NavinduThimodya/High-Frequency-Amplifier-Design/Images/WhatsApp Image 2023-11-27 at 21.41.31_52dbc793.jpg

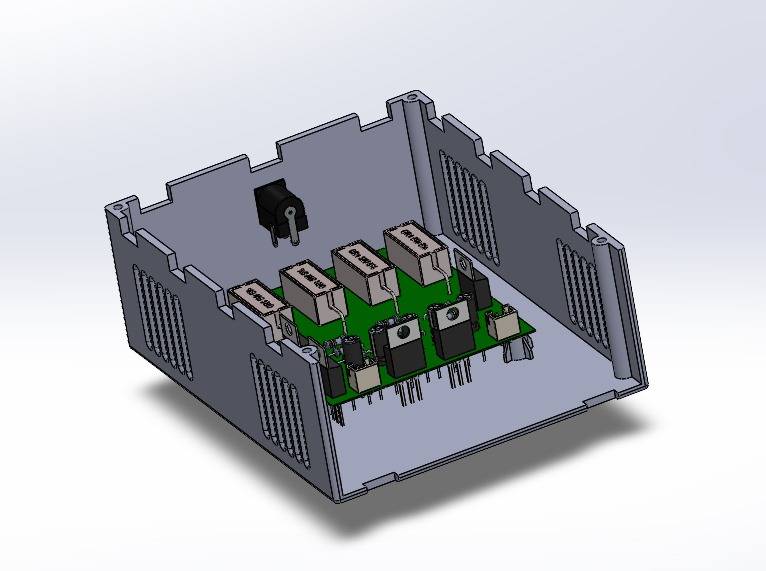
Images/WhatsApp Image 2023-11-27 at 21.41.31_52dbc793.jpg
