NavinduThimodya/High-Frequency-Amplifier-Design/Images/WhatsApp Image 2023-11-05 at 13.38.32_527a01cc.jpg

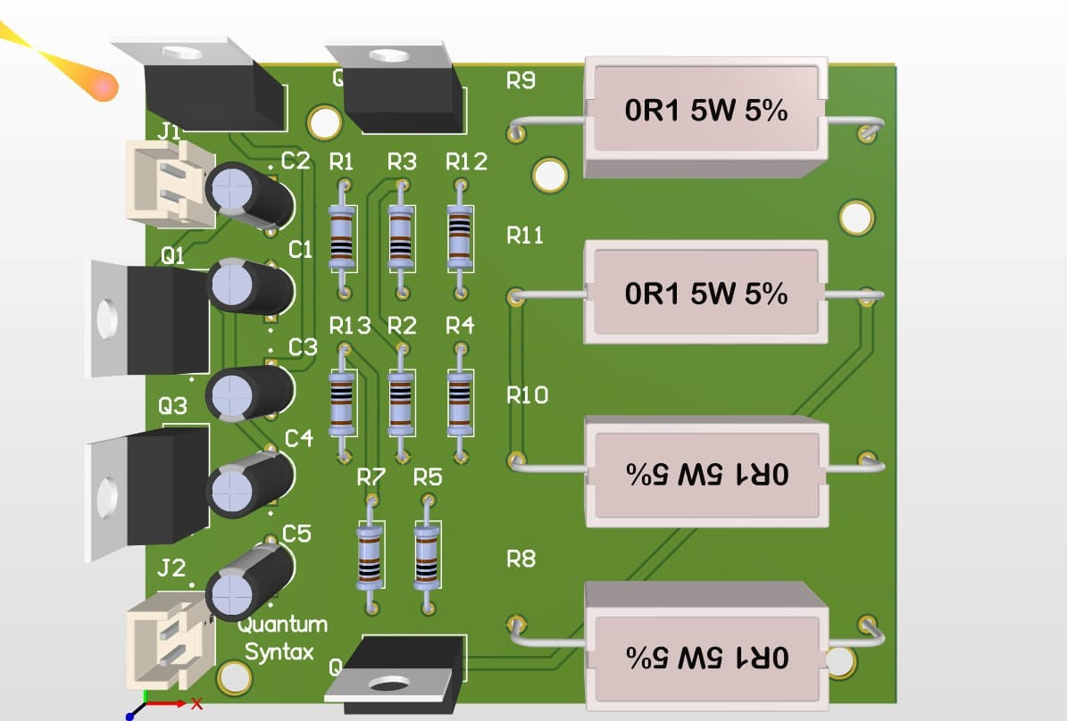
Images/WhatsApp Image 2023-11-05 at 13.38.32_527a01cc.jpg
