NavinduThimodya/High-Frequency-Amplifier-Design/Demostration/WhatsApp Image 2023-10-17 at 14.30.10_1659dff2.jpg

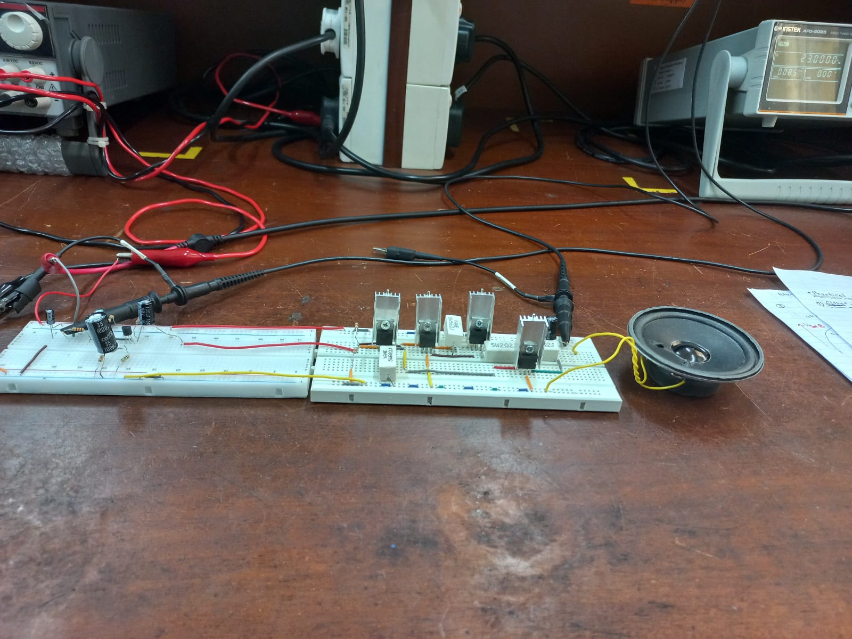
Demostration/WhatsApp Image 2023-10-17 at 14.30.10_1659dff2.jpg
