NavinduThimodya/High-Frequency-Amplifier-Design/Demostration/WhatsApp Image 2023-10-17 at 14.30.11_a0c9a58f.jpg

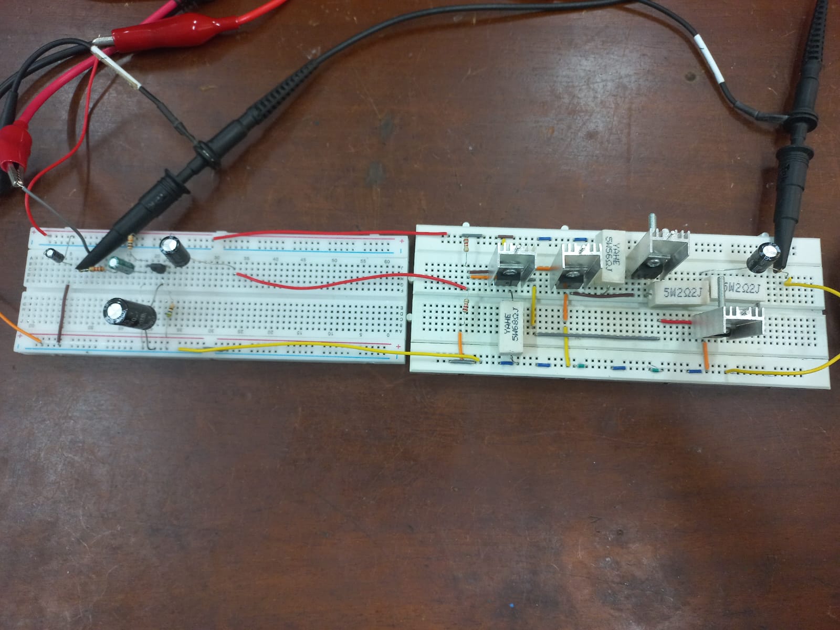
Demostration/WhatsApp Image 2023-10-17 at 14.30.11_a0c9a58f.jpg
