NavinduThimodya/High-Frequency-Amplifier-Design/Demostration/WhatsApp Image 2023-10-17 at 14.30.12_52d10109.jpg

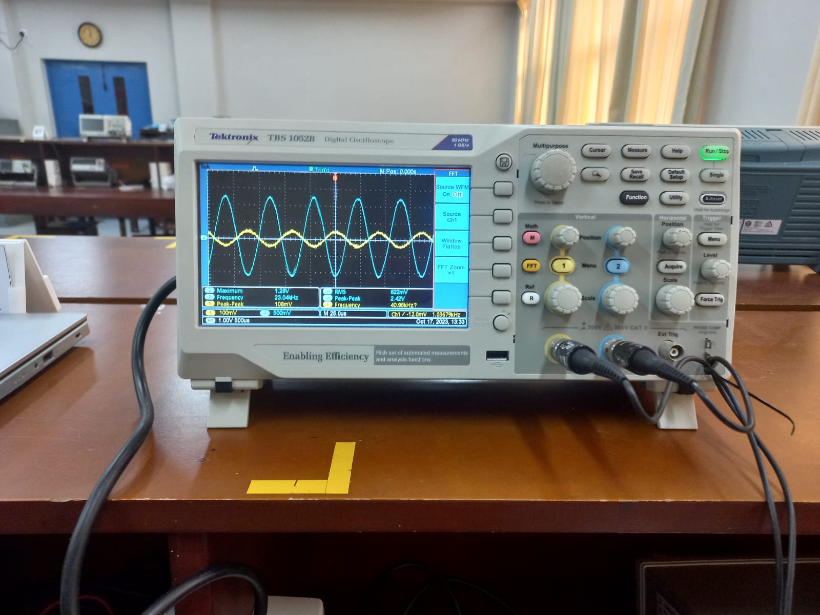
Demostration/WhatsApp Image 2023-10-17 at 14.30.12_52d10109.jpg
