NavinduThimodya/High-Frequency-Amplifier-Design/Images/WhatsApp Image 2023-11-05 at 13.38.31_9597cb62.jpg

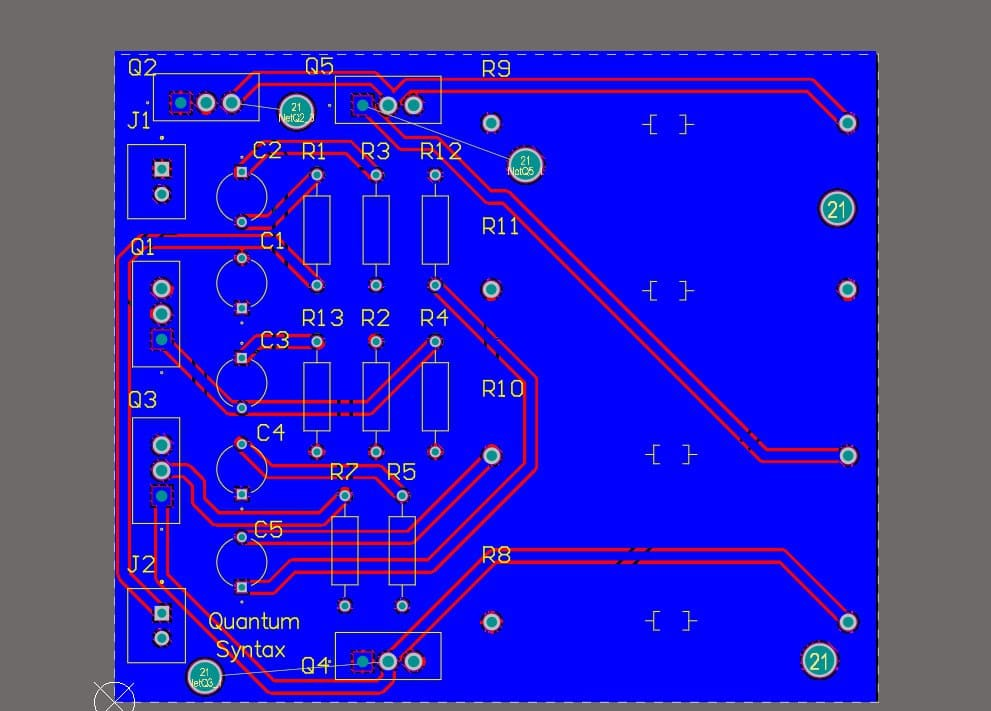
Images/WhatsApp Image 2023-11-05 at 13.38.31_9597cb62.jpg
