NavinduThimodya/High-Frequency-Amplifier-Design/Images/WhatsApp Image 2023-11-05 at 13.38.32_2c939def.jpg

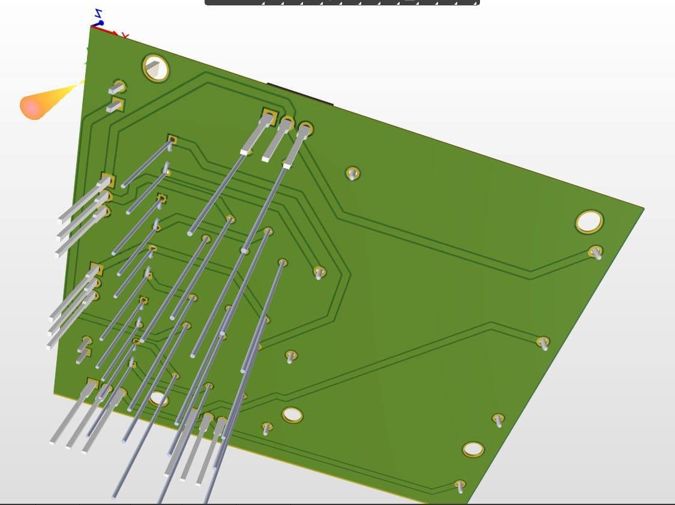
Images/WhatsApp Image 2023-11-05 at 13.38.32_2c939def.jpg
