NavinduThimodya/High-Frequency-Amplifier-Design/Images/WhatsApp Image 2023-11-05 at 13.38.32_6cdb0048.jpg

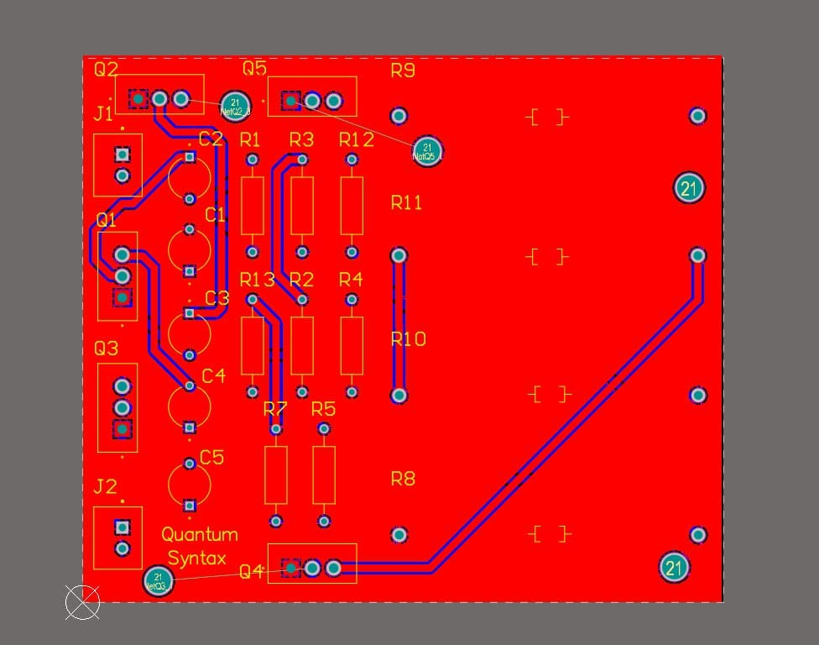
Images/WhatsApp Image 2023-11-05 at 13.38.32_6cdb0048.jpg
