NavinduThimodya/High-Frequency-Amplifier-Design/Images/WhatsApp Image 2023-11-27 at 21.41.30_6bb2576d.jpg

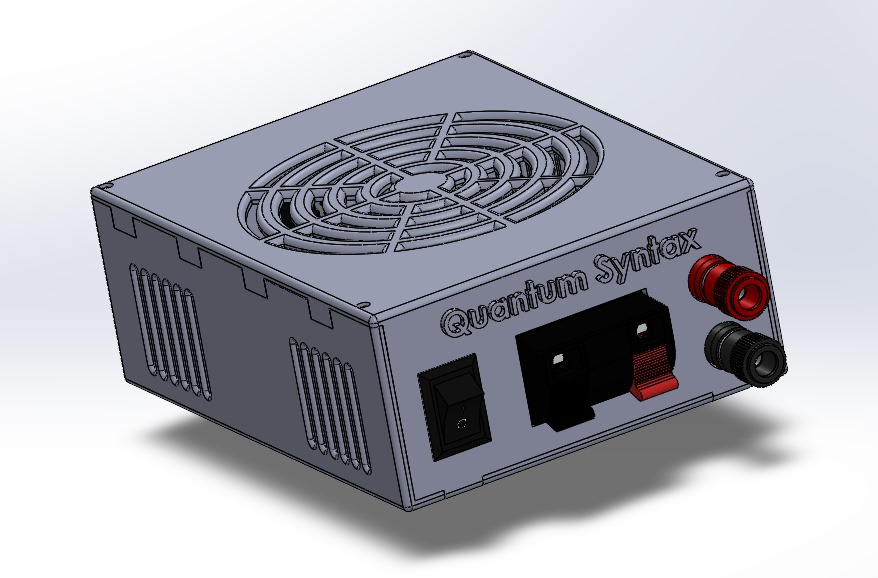
Images/WhatsApp Image 2023-11-27 at 21.41.30_6bb2576d.jpg
