NavinduThimodya/High-Frequency-Amplifier-Design/Images/WhatsApp Image 2023-11-27 at 21.41.31_a6b195c2.jpg

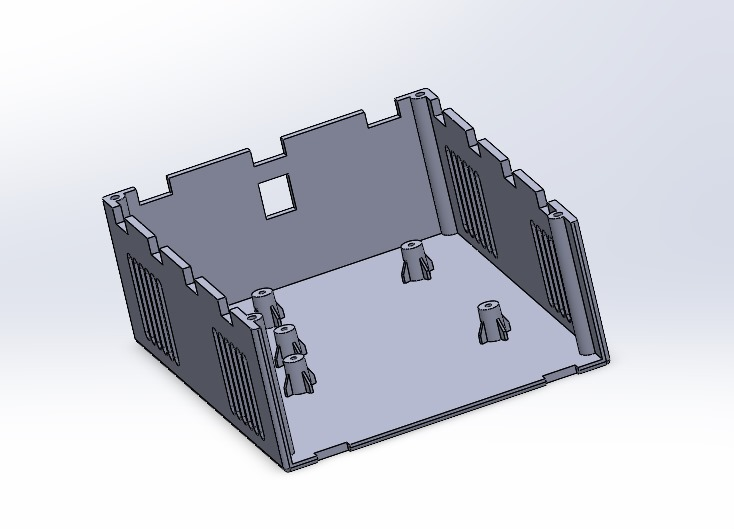
Images/WhatsApp Image 2023-11-27 at 21.41.31_a6b195c2.jpg
