NavinduThimodya/High-Frequency-Amplifier-Design/Images/WhatsApp Image 2023-12-04 at 17.01.40_ac61a306.jpg

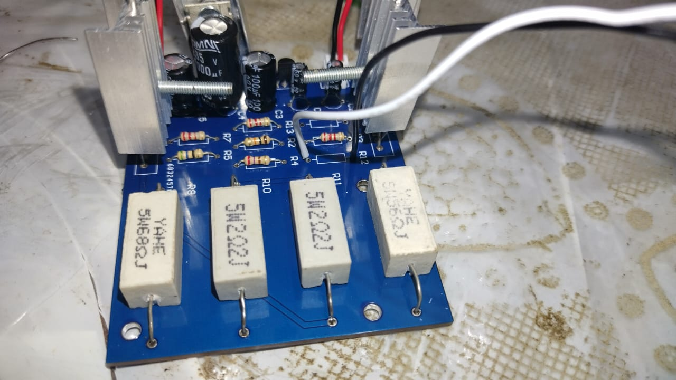
Images/WhatsApp Image 2023-12-04 at 17.01.40_ac61a306.jpg
