NavinduThimodya/High-Frequency-Amplifier-Design/Images/WhatsApp Image 2023-12-04 at 17.01.40_e7751b88.jpg

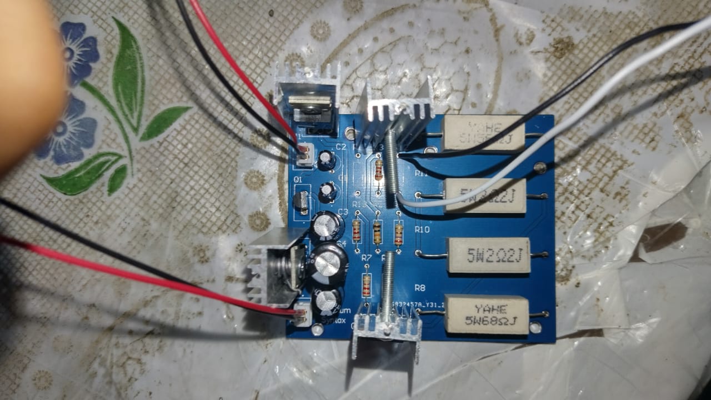
Images/WhatsApp Image 2023-12-04 at 17.01.40_e7751b88.jpg
