NavinduThimodya/High-Frequency-Amplifier-Design/Images/WhatsApp Image 2023-12-04 at 17.01.41_f10232e3.jpg

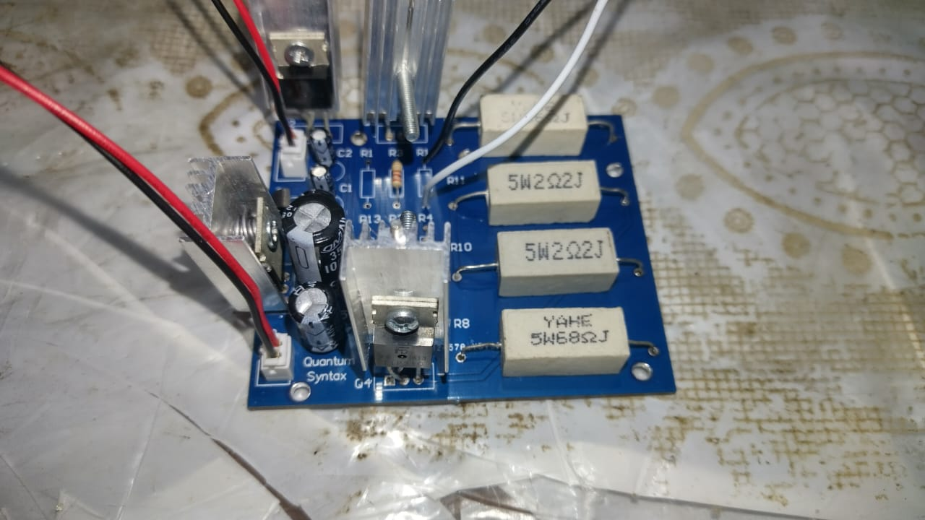
Images/WhatsApp Image 2023-12-04 at 17.01.41_f10232e3.jpg
