NavinduThimodya/High-Frequency-Amplifier-Design/SOLIDWORKS files/Part2.SLDPRT

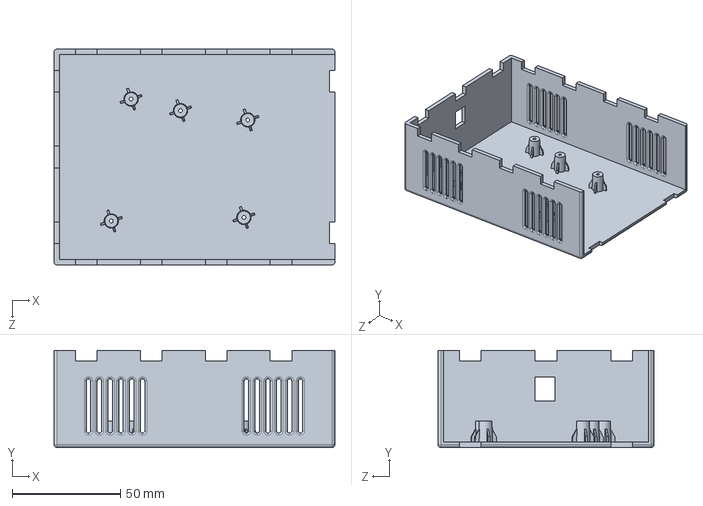
[picture p35: CAD file, 2024-09-05]
SOLIDWORKS files/Part2.SLDPRT
130.0 x 45.0 x 100.0 mm
