NavinduThimodya/High-Frequency-Amplifier-Design/SOLIDWORKS files/Banana Connector - 4.00mm - Long - Red.SLDPRT

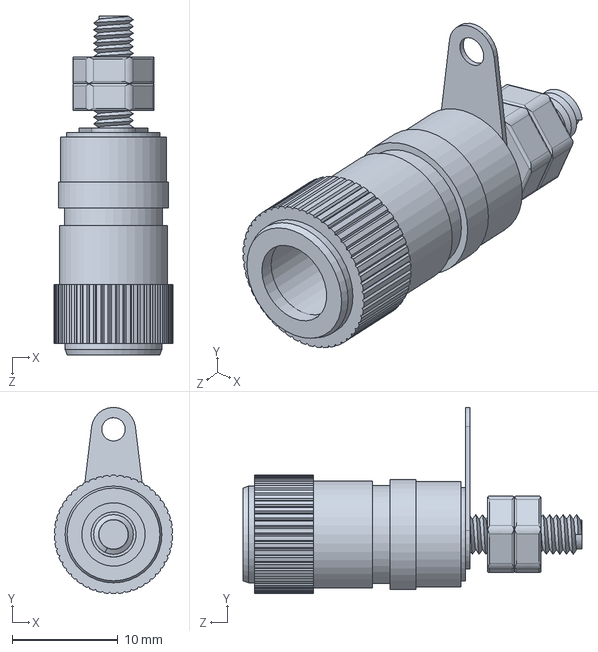
[picture p36: CAD file, 2024-09-05]
SOLIDWORKS files/Banana Connector - 4.00mm - Long - Red.SLDPRT
11.2 x 17.6 x 32.0 mm
