NavinduThimodya/High-Frequency-Amplifier-Design/SOLIDWORKS files/Part1.SLDPRT

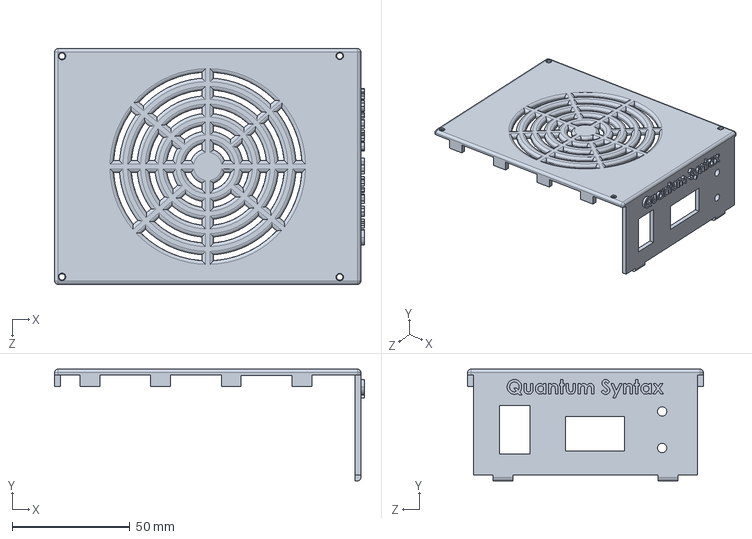
[picture p37: CAD file, 2024-09-05]
SOLIDWORKS files/Part1.SLDPRT
131.5 x 47.5 x 100.0 mm
