NavinduThimodya/High-Frequency-Amplifier-Design/SOLIDWORKS files/RockerSwitch.SLDPRT

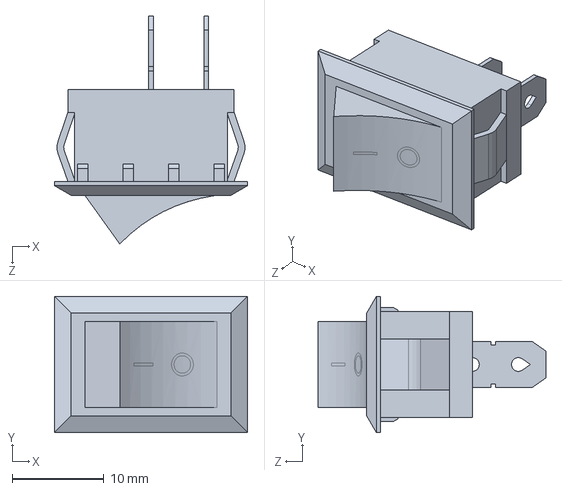
[picture p38: CAD file, 2024-09-05]
SOLIDWORKS files/RockerSwitch.SLDPRT
21.0 x 14.8 x 24.8 mm
