NavinduThimodya/High-Frequency-Amplifier-Design/SOLIDWORKS files/DC socket.SLDPRT

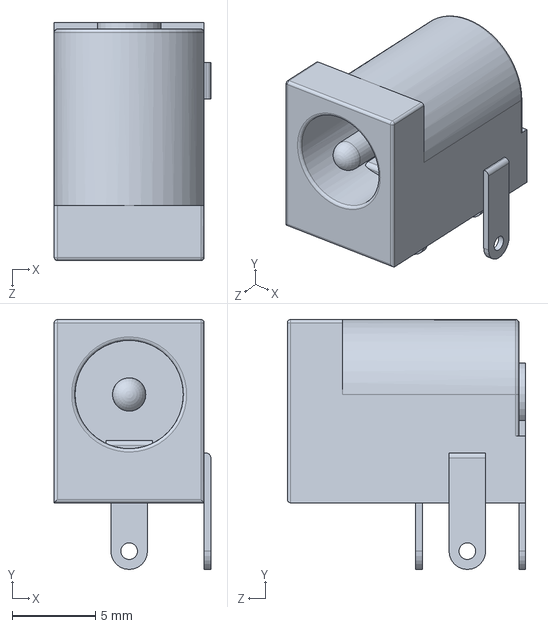
[picture p39: CAD file, 2024-09-05]
SOLIDWORKS files/DC socket.SLDPRT
9.40 x 15.0 x 14.3 mm
