NavinduThimodya/High-Frequency-Amplifier-Design/SOLIDWORKS files/Connector.SLDPRT

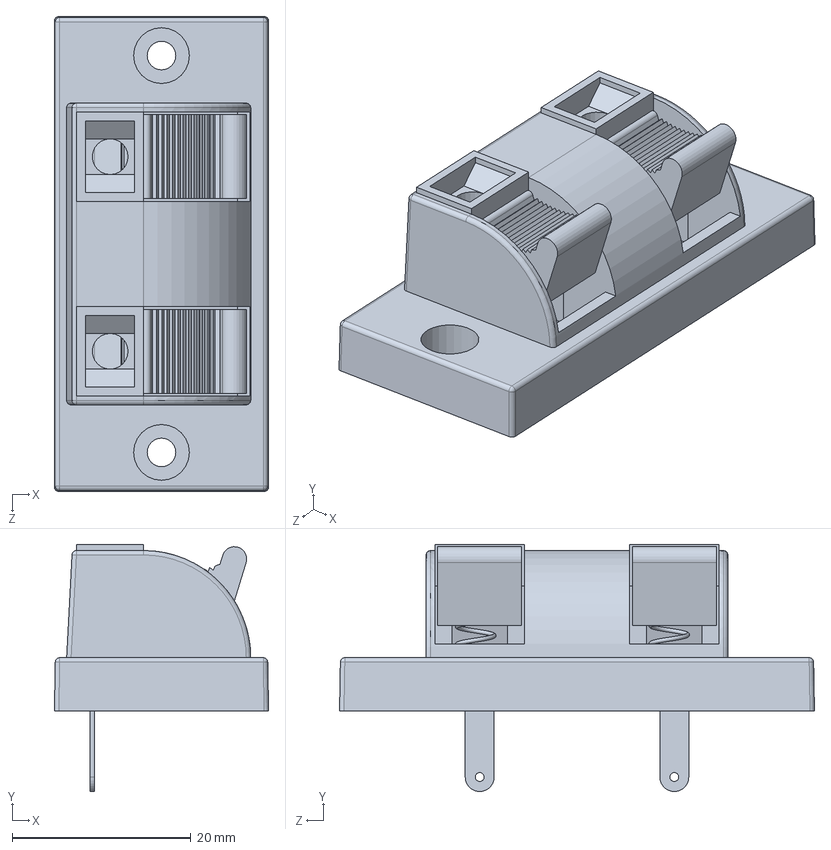
[picture p40: CAD file, 2024-09-05]
SOLIDWORKS files/Connector.SLDPRT
24.0 x 27.7 x 53.2 mm
