NavinduThimodya/High-Frequency-Amplifier-Design/(list of files, cad)

Other CAD files:
SOLIDWORKS files/Banana Connector - 4.00mm - Long - Black.SLDPRT
SOLIDWORKS files/Part1.STL
SOLIDWORKS files/Part2.STL
