NavinduThimodya/High-Frequency-Amplifier-Design/(list of files, drawings)

Other design files:
PCB files/A_PCB.PcbDoc
PCB files/A_PCB_Project.PrjPcb
PCB files/PCB_Schematic.SchDoc
